Ryan-Ellison/RoboTuner/desktopApplication/CADFiles/clampConnectionVers.SLDPRT

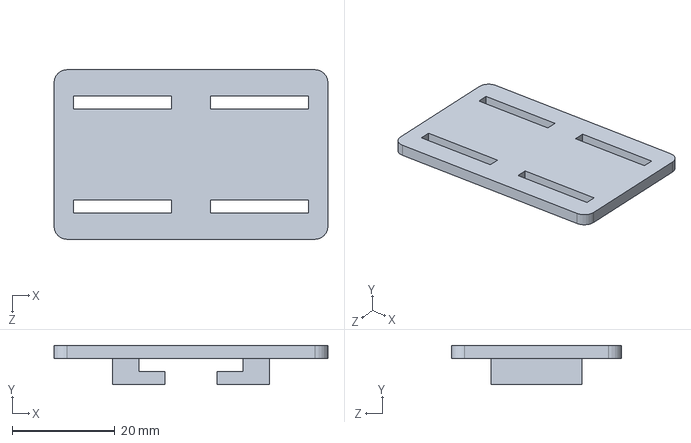
[picture p1: CAD file, 2023-11-03]
desktopApplication/CADFiles/clampConnectionVers.SLDPRT
53.3 x 7.62 x 33.0 mm
