Ryan-Ellison/RoboTuner/desktopApplication/CADFiles/clampConnectionElectronicsVers.SLDPRT

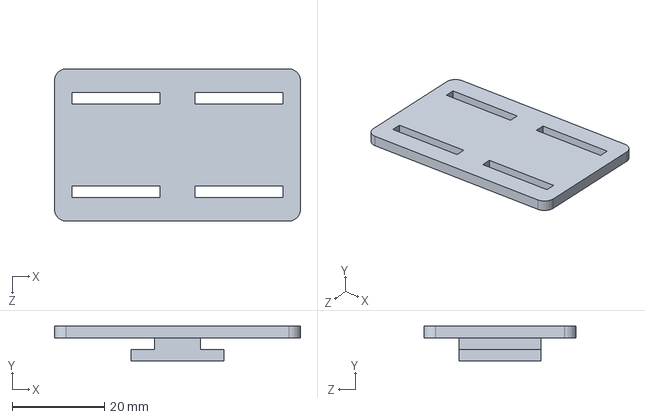
[picture p2: CAD file, 2023-11-03]
desktopApplication/CADFiles/clampConnectionElectronicsVers.SLDPRT
53.3 x 7.56 x 33.0 mm
