Ryan-Ellison/RoboTuner/desktopApplication/CADFiles/batteryLidVers.SLDPRT

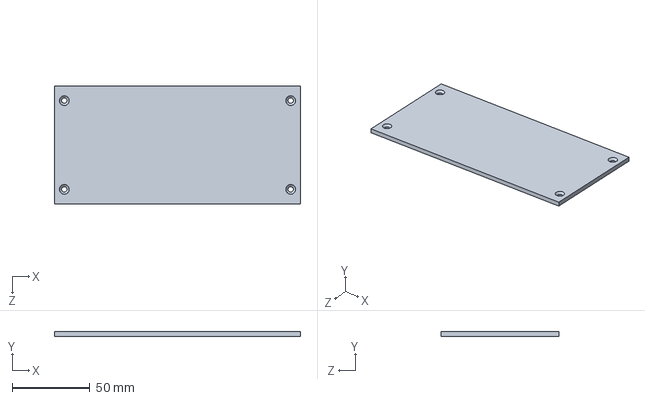
[picture p3: CAD file, 2023-11-03]
desktopApplication/CADFiles/batteryLidVers.SLDPRT
158.4 x 3.00 x 75.9 mm
