Ryan-Ellison/RoboTuner/desktopApplication/CADFiles/linkerVers.SLDPRT

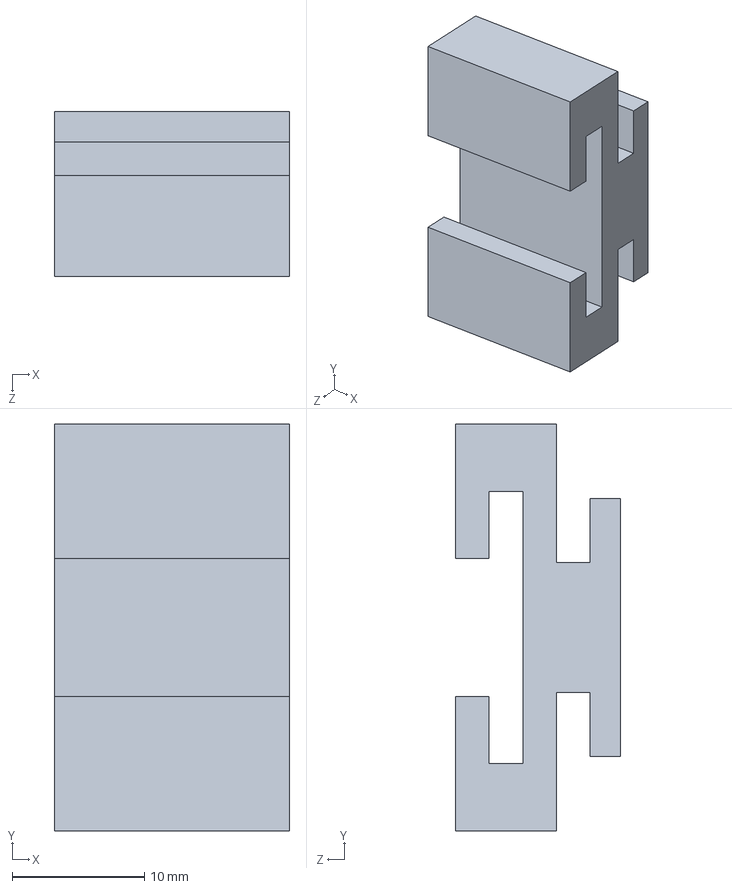
[picture p4: CAD file, 2023-11-03]
desktopApplication/CADFiles/linkerVers.SLDPRT
17.8 x 30.7 x 12.4 mm
