Ryan-Ellison/RoboTuner/desktopApplication/CADFiles/keyVers.SLDPRT

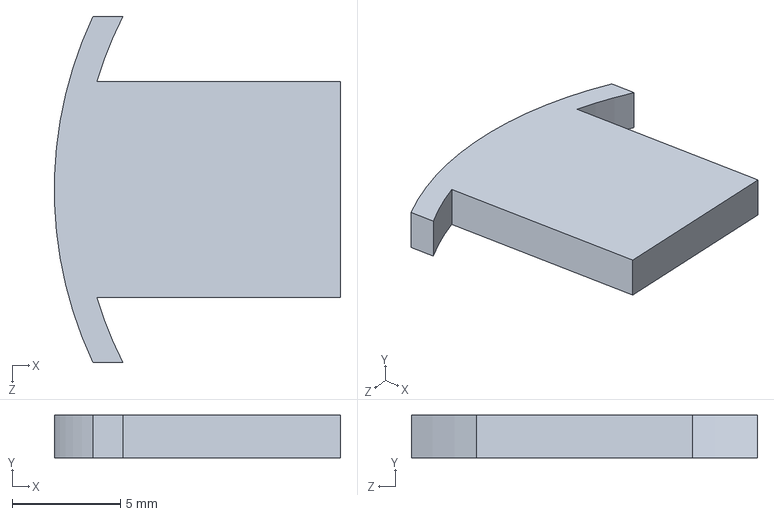
[picture p5: CAD file, 2023-11-03]
desktopApplication/CADFiles/keyVers.SLDPRT
13.2 x 1.97 x 15.9 mm
