Ryan-Ellison/RoboTuner/desktopApplication/CADFiles/raspPiHousingVers.SLDPRT

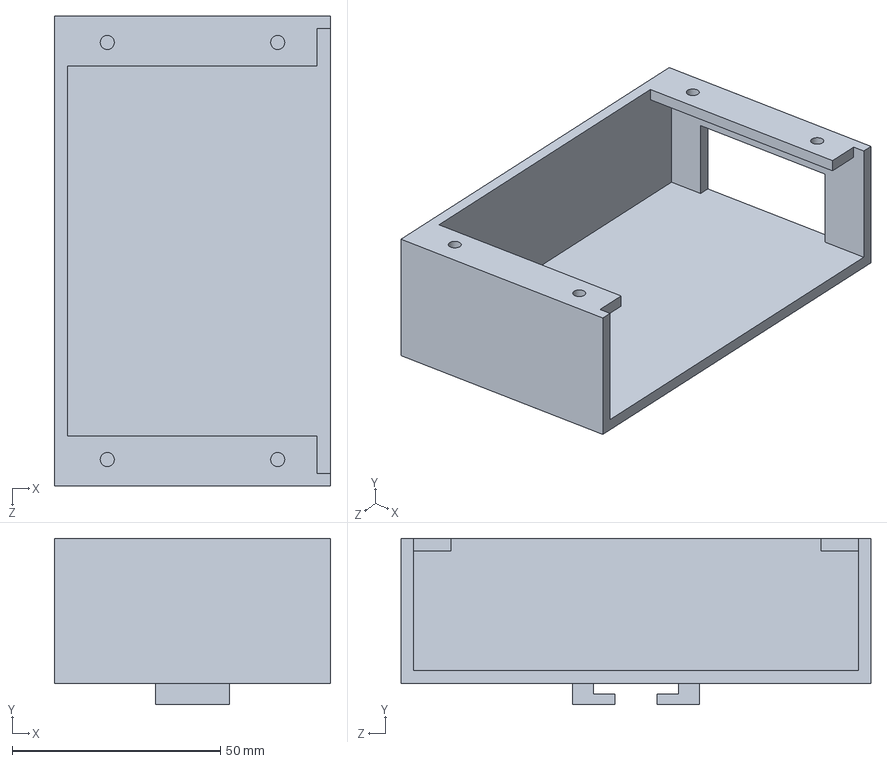
[picture p6: CAD file, 2023-11-03]
desktopApplication/CADFiles/raspPiHousingVers.SLDPRT
66.3 x 39.9 x 112.8 mm
