Ryan-Ellison/RoboTuner/desktopApplication/CADFiles/batteryBoxVers.SLDPRT

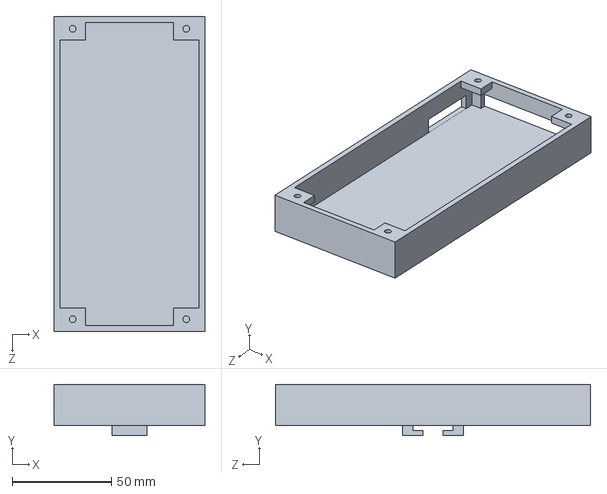
[picture p7: CAD file, 2023-11-03]
desktopApplication/CADFiles/batteryBoxVers.SLDPRT
75.9 x 25.9 x 158.4 mm
