Ryan-Ellison/RoboTuner/desktopApplication/CADFiles/outerConnectionVers.SLDPRT

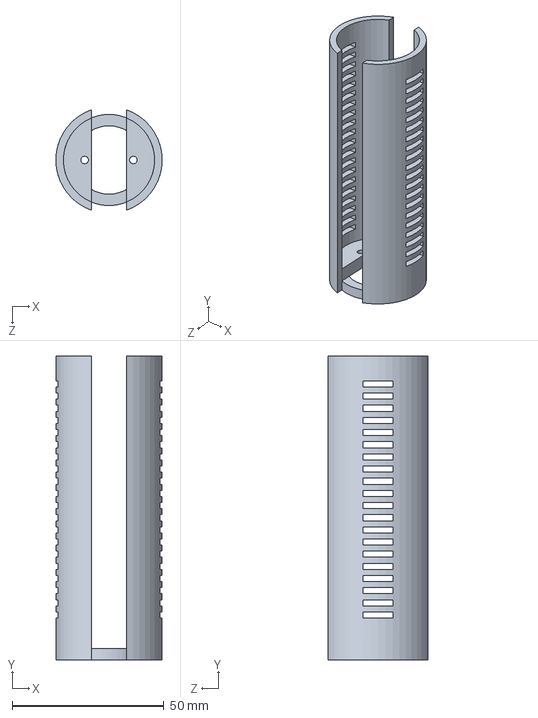
[picture p8: CAD file, 2023-11-03]
desktopApplication/CADFiles/outerConnectionVers.SLDPRT
35.0 x 100.0 x 33.1 mm
