Ryan-Ellison/RoboTuner/desktopApplication/CADFiles/innerConnectionVers.SLDPRT

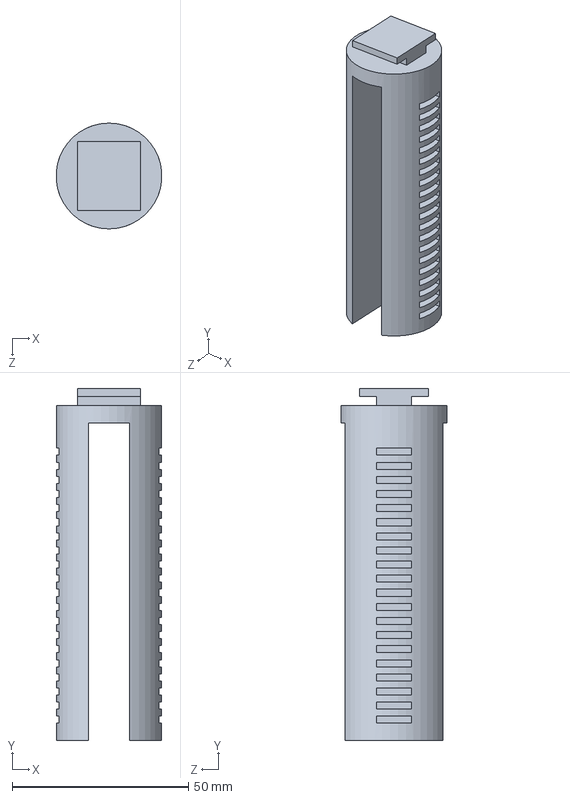
[picture p9: CAD file, 2023-11-03]
desktopApplication/CADFiles/innerConnectionVers.SLDPRT
29.9 x 99.8 x 30.0 mm
