Ryan-Ellison/RoboTuner/desktopApplication/CADFiles/electronicsLidRaspPiVers.SLDPRT

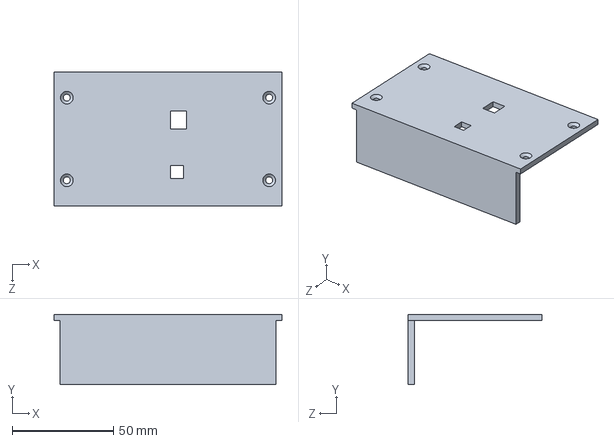
[picture p10: CAD file, 2023-11-03]
desktopApplication/CADFiles/electronicsLidRaspPiVers.SLDPRT
112.8 x 34.8 x 66.3 mm
