Ryan-Ellison/RoboTuner/desktopApplication/CADFiles/servoBoxVers.SLDPRT

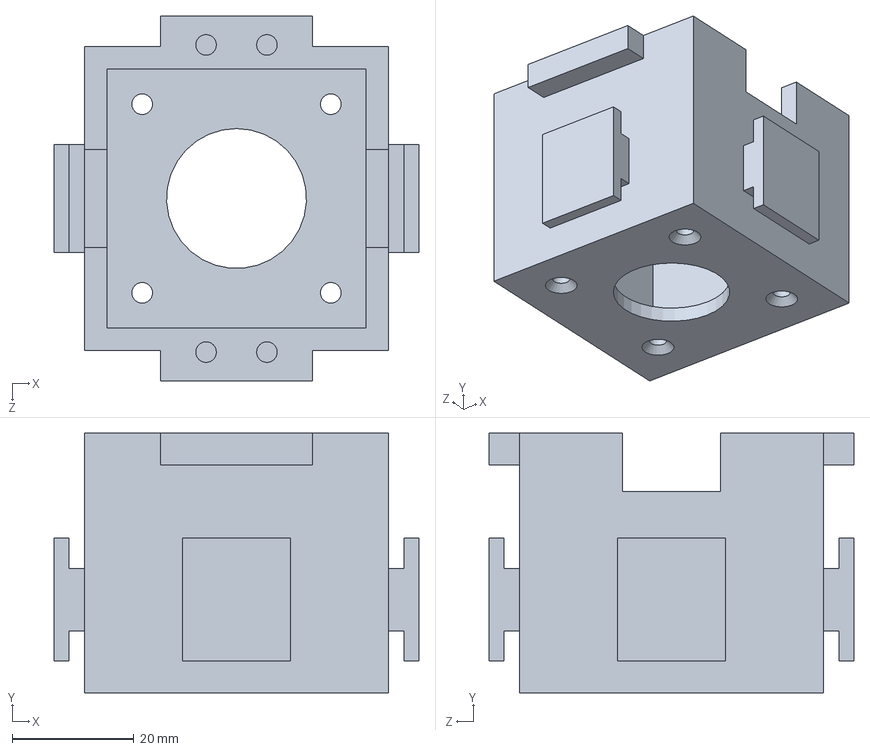
[picture p11: CAD file, 2023-11-03]
desktopApplication/CADFiles/servoBoxVers.SLDPRT
60.0 x 42.7 x 60.0 mm
