Ryan-Ellison/RoboTuner/desktopApplication/CADFiles/servoBox.SLDPRT

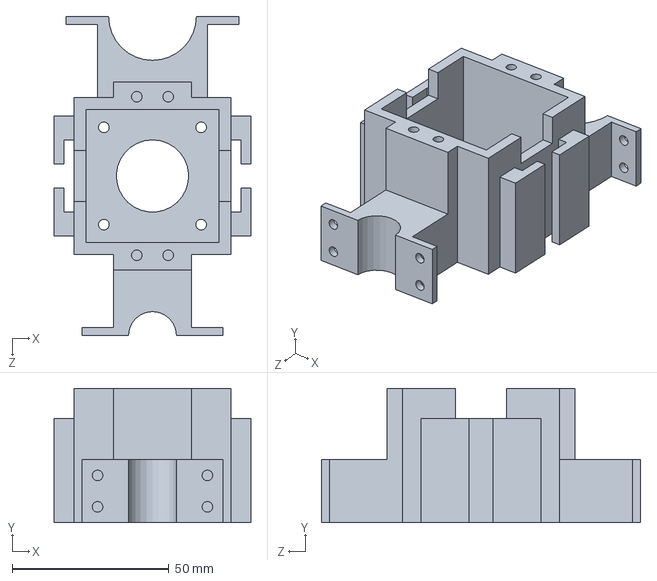
[picture p12: CAD file, 2023-10-13]
desktopApplication/CADFiles/servoBox.SLDPRT
62.7 x 42.7 x 101.6 mm
