Ryan-Ellison/RoboTuner/desktopApplication/CADFiles/topOfConnection.SLDPRT

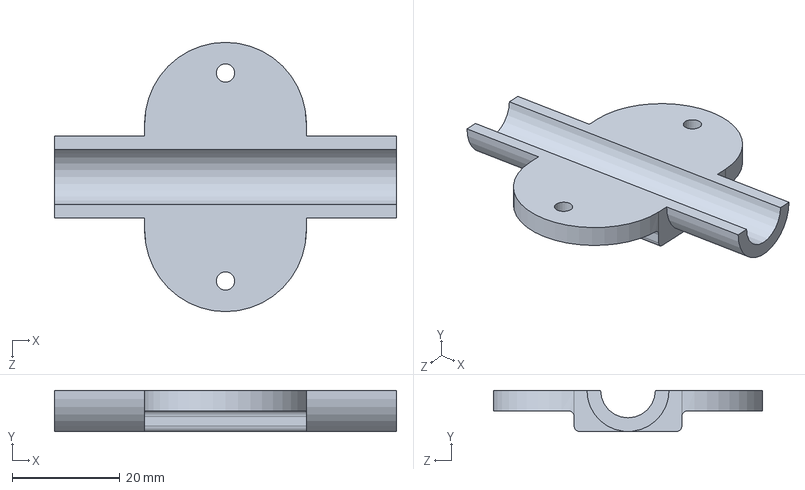
[picture p13: CAD file, 2023-10-13]
desktopApplication/CADFiles/topOfConnection.SLDPRT
63.5 x 7.62 x 50.0 mm
