Ryan-Ellison/RoboTuner/desktopApplication/CADFiles/boxTopVers.SLDPRT

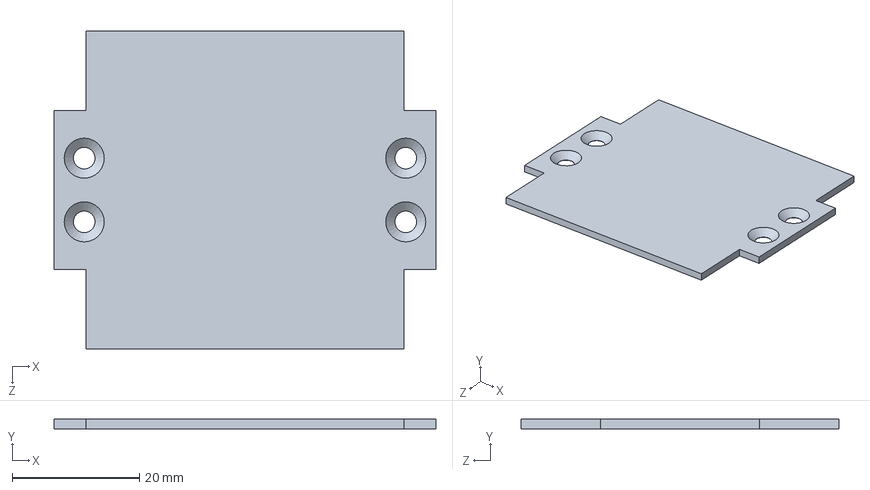
[picture p14: CAD file, 2023-10-13]
desktopApplication/CADFiles/boxTopVers.SLDPRT
60.0 x 1.50 x 50.0 mm
