Ryan-Ellison/RoboTuner/desktopApplication/CADFiles/bigClamp.SLDPRT

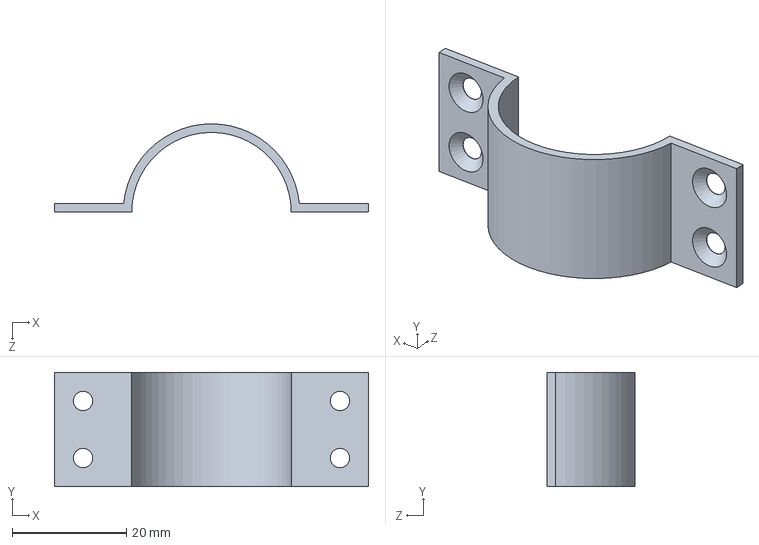
[picture p15: CAD file, 2023-10-13]
desktopApplication/CADFiles/bigClamp.SLDPRT
55.0 x 20.0 x 15.5 mm
