Ryan-Ellison/RoboTuner/desktopApplication/CADFiles/Connection.SLDPRT

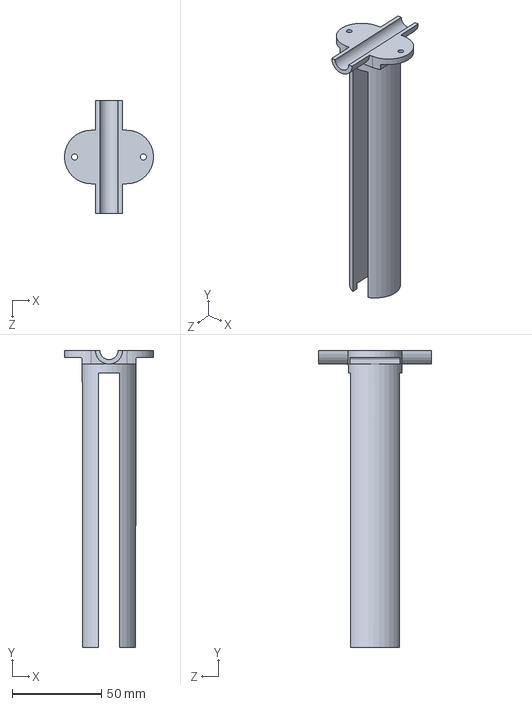
[picture p16: CAD file, 2023-10-13]
desktopApplication/CADFiles/Connection.SLDPRT
50.0 x 166.4 x 63.5 mm
