Ryan-Ellison/RoboTuner/desktopApplication/CADFiles/raspPiHousing.SLDPRT

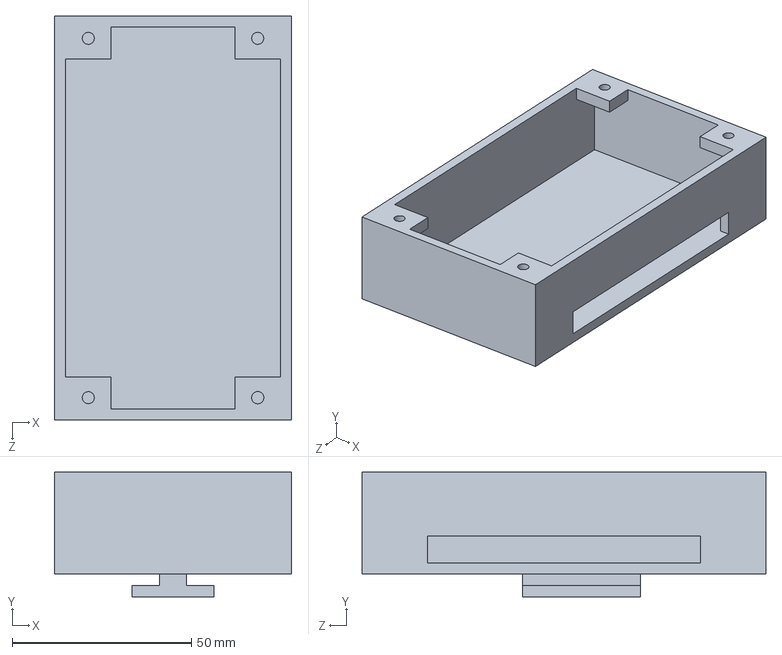
[picture p17: CAD file, 2023-10-13]
desktopApplication/CADFiles/raspPiHousing.SLDPRT
66.3 x 34.8 x 112.8 mm
