Ryan-Ellison/RoboTuner/desktopApplication/CADFiles/smallClamp.SLDPRT

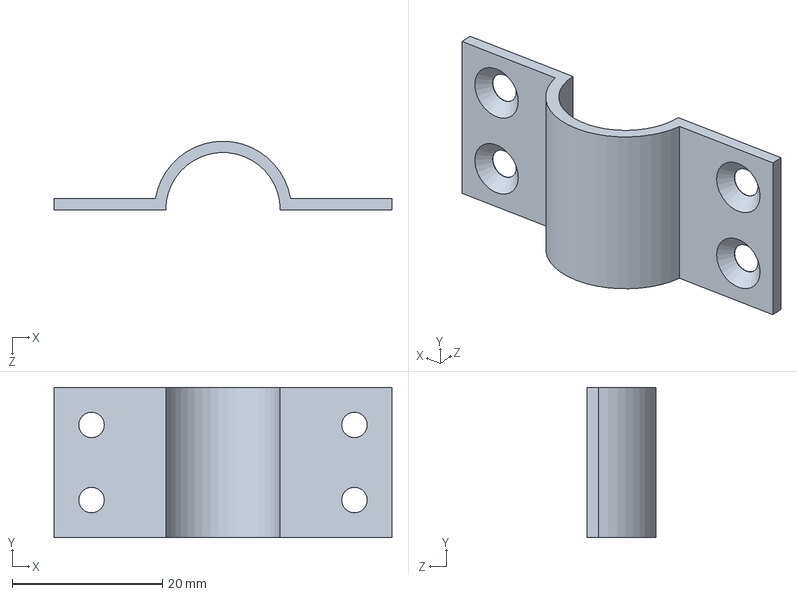
[picture p18: CAD file, 2023-10-13]
desktopApplication/CADFiles/smallClamp.SLDPRT
45.0 x 20.0 x 9.12 mm
