Ryan-Ellison/RoboTuner/desktopApplication/CADFiles/electronicsLidRaspPi.SLDPRT

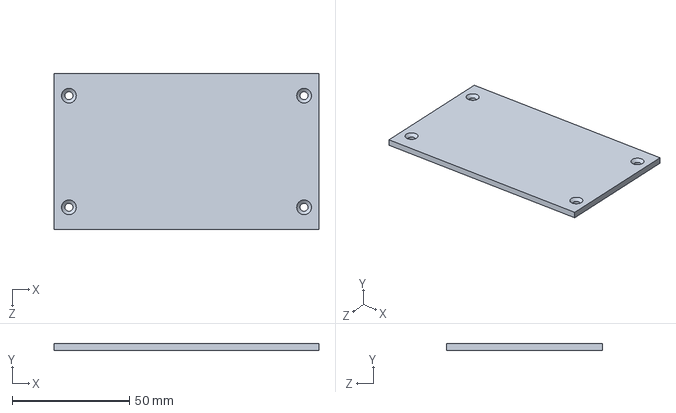
[picture p19: CAD file, 2023-10-13]
desktopApplication/CADFiles/electronicsLidRaspPi.SLDPRT
112.8 x 3.00 x 66.3 mm
