Ryan-Ellison/RoboTuner/desktopApplication/CADFiles/batteryBox.SLDPRT

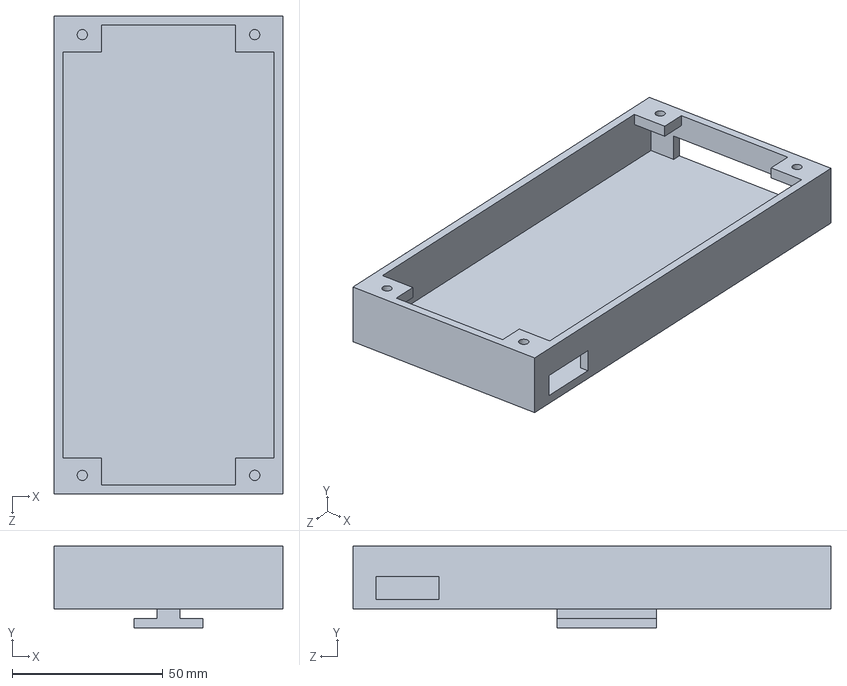
[picture p20: CAD file, 2023-10-13]
desktopApplication/CADFiles/batteryBox.SLDPRT
75.9 x 27.1 x 158.4 mm
