Ryan-Ellison/RoboTuner/(list of files, cad)

Other CAD files:
desktopApplication/CADFiles/batteryLid.SLDPRT
