Ryan-Ellison/RoboTuner/desktopApplication/tabManager.py

import sys
import os
    
PATH = "/Users/ryanellison/VSCode Projects/RoboTuner/"

sys.path.insert(0, PATH)
os.chdir(PATH)

from editSettingsPage import ProfileInputWindow
from landingPage import LandingPage
from cadFilesPage import CADFilesWindow
from noteDisplayPage import NoteDisplayPage
from hardwareSpecificationsPage import HardwareSpecificationsPage
from tuningTendencyPage import TuningTendencyWindow
from manualPage import ManualWindow
from bluetoothPage import bluetoothPage

from PyQt6.QtWidgets import (
    QApplication,
    QMainWindow,
    QTabWidget,
)
    

print("path in os: " + os.getcwd())


class TabManager(QMainWindow):
    def __init__(self):
        super().__init__()

        self.setWindowTitle("RoboTuner")

        self.tabs = QTabWidget()
        self.tabs.setTabPosition(QTabWidget.TabPosition.North)
        self.tabs.setMovable(False)
        self.tabs.setDocumentMode(True)

        self.landingPage = LandingPage()
        self.profileInputWindow = ProfileInputWindow()
        self.cadFilesWindow = CADFilesWindow()
        self.noteDiplayPage = NoteDisplayPage()
        self.hardwareSpecificationsPage = HardwareSpecificationsPage()
        self.tuningTendencyWindow = TuningTendencyWindow()
        self.manualWindow = ManualWindow()
        self.bluetoothWindow = bluetoothPage()

        self.tabs.addTab(self.landingPage, "Landing Page")
        self.tabs.addTab(self.profileInputWindow, "Edit settings")
        self.tabs.addTab(self.cadFilesWindow, "CAD Files")
        self.tabs.addTab(self.noteDiplayPage, "Display Note")
        self.tabs.addTab(self.hardwareSpecificationsPage, "Hardware Specifications")
        self.tabs.addTab(self.tuningTendencyWindow, "Tuning Information")
        self.tabs.addTab(self.manualWindow, "Manual")
        self.tabs.addTab(self.bluetoothWindow, "Bluetooth example")

        self.tabs.setMovable(True)

        self.setCentralWidget(self.tabs)
app = QApplication(sys.argv)

window = TabManager()
window.show()

app.exec()
