Ryan-Ellison/RoboTuner/raspi/TMC2209_testing.py

'''
from TMC_2209.TMC_2209_StepperDriver import *
import time

tmc = TMC_2209(21, 16, 20)

tmc.set_direction_reg(False)
tmc.set_current(1300)
tmc.set_interpolation(True)
tmc.set_spreadcycle(False)
tmc.set_microstepping_resolution(2)
tmc.set_internal_rsense(False)

tmc.set_acceleration(2000)
tmc.set_max_speed(1000)


def callback(_):
	print("StallGuard!")
	tmc.stop(stop_mode=StopMode.HARDSTOP)
	
tmc.set_stallguard_callback(19, 1, callback, 1)


tmc.set_motor_enabled(True)
tmc.run_to_position_steps(10, MovementAbsRel.RELATIVE)

success = tmc.run_to_position_steps(10000, MovementAbsRel.RELATIVE)
time.sleep(2)
success = tmc.run_to_position_steps(-10000, MovementAbsRel.RELATIVE)

print(tmc.get_steps_per_revolution())

tmc.set_motor_enabled(False)
'''
from Motor import Motor
import os

os.system("stty -echo")

motor = Motor(100)
pos = None

print("'w':	push\n's':	pull")
while True:
	key = input("")
	if key == 'w':
		motor.push(10)
		print("push")
		
	if key == 's':
		motor.pull(10)
		print("pull")
		
	if key == '1':
		motor.led_R()
		
	if key == '2':
		motor.led_G()
		
	if key == '3':
		motor.led_B()
		
	if key == 'o':
		motor.led_Off()
		
	if (pos != motor.get_position()):
		pos = motor.get_position()
		print(pos)

os.system("stty echo")
termios.tcflush(sys.stdin, termios.TCIOFLUSH)
