Ryan-Ellison/RoboTuner/(commit log)

2023-09-30 Learning buttons
2023-10-01 First prototype for user inputs
2023-10-02 raspi library setup for motor control
2023-10-02 initial testing of motor control
2023-10-08 found distances per step and made motor quieter
2023-10-09 Configured tolerance level and overall speed in order to achieve better results in terms of accuracy.
    Added some features to the Note class for measuring tuning tendencies for notes and added a few lines of code to the controller class to test them.
    [Controller.py, Note.py, Tuner.py]
2023-10-12 CAD Files Page
2023-10-13 made motor movement to work with tuner
2023-10-13 Fixed some invalid value bugs
    [Controller.py, Note.py, Tuner.py]
2023-10-13 updated Motor.py small mistakes
    [Motor.py]
2023-10-13 Necessary changes to work with desktop application
    [Connection.SLDPRT, batteryBox.SLDPRT, batteryLid.SLDPRT, bigClamp.SLDPRT, boxTop.SLDPRT, electronicsLidRaspPi.SLDPRT, raspPiHousing.SLDPRT, servoBox.SLDPRT]
2023-10-13 set up resistance light demo
2023-10-23 changed motor driver and tested
2023-10-29 made/tested new motor class for TMC2209
2023-10-29 added resistance check and home functions
2023-10-30 Added calls to motor class from controller. Created configuration for tuning algorithms.
2023-11-01 motor working with new driver and raspi
2023-11-02 completed Motor class
2023-11-02 script to home motor on start
2023-11-02 battery tester script and log out
2023-11-03 Update Raspberry Pi Config File
2023-11-03 robustness to raspberry pi interactions
2023-11-03 added reference pitch and made final changes
2023-11-06 Removed redundant pitch computations, increasing speed significantly.
2023-12-01 fixed mm to steps, steps to mm
    [Motor.py]
